samuelpabuena2008/capsense-lab/docs/arquitectura.md

# Arquitectura

El dashboard está separado en capas. Cada capa solo conoce a la de abajo, así la matemática se prueba sin hardware y la interfaz no sabe si los datos vienen del Arduino, del simulador o de un archivo.

```mermaid
flowchart LR
    subgraph Fuentes["io/ · fuentes de datos (un hilo cada una)"]
        A[serial_source<br/>Arduino por USB]
        B[simulator_source<br/>modo demo]
        C[replay_source<br/>log o CSV]
    end
    A & B & C -- "líneas de texto" --> P[io/protocol<br/>parser → eventos]
    P --> S[services/session<br/>estado + mediciones<br/>con lock]
    S --> L[services/storage<br/>logs/ por sesión]
    S -- "snapshot()" --> U[ui/<br/>Dash + Plotly]
    D[domain/<br/>physics · steps · models] --> U
    D --> S
    U -- "Medir → M" --> A
    U -- "Medir → M" --> B
```

## Capas

| Capa | Archivos | Qué hace | Depende de |
|---|---|---|---|
| Dominio | `domain/models.py`, `physics.py`, `steps.py` | Dataclasses, réplica de la matemática del firmware y los pasos con números sustituidos. Sin serial ni UI. | nada |
| Entrada | `io/base.py`, `protocol.py`, `*_source.py` | Las tres fuentes entregan **texto línea por línea**, como el puerto serie. El parser lo convierte en eventos. | dominio |
| Servicios | `services/session.py`, `storage.py` | Estado del equipo, ciclo de vida de cada medición, historial y logs. | dominio, entrada |
| Interfaz | `ui/app.py`, `layout.py`, `callbacks.py`, `figures.py`, `formulas.py` | Página Dash. Lee la sesión cada 400 ms y solo redibuja si cambió `version`. | todas |

## Hilos

- Cada fuente corre en su propio hilo `daemon` y llama a `Session.recibir_linea()`.
- `Session` protege todo con un único `RLock`. La interfaz pide `snapshot()`, que devuelve copias.
- Las `Run` no se modifican después de agregarse a una medición (los t1/t2 de la v2.1 se reconstruyen antes, dentro del lock).

## Estados del equipo

```mermaid
stateDiagram-v2
    [*] --> Desconectado
    Desconectado --> Conectado: se abre el puerto
    Conectado --> Listo: #VERSION / #LISTO
    Listo --> Descargando: #INICIO
    Descargando --> Midiendo: #PRUEBA_INI
    Midiendo --> Descargando: #PRUEBA
    Descargando --> Listo: #RESULTADO / #FIN
    Midiendo --> Error: #ERROR
    Error --> Descargando: #INICIO (nueva medición)
    Listo --> Desconectado: se suelta el cable
```

Con el firmware v2.1 no hay `#PRUEBA_INI`: el estado pasa a *Midiendo* con la cabecera de la tabla y a *Listo* con la línea CSV del resultado.

## Simulación del circuito

`domain/simulation.py` tiene la física pura (carga, descarga, fuga, ADC) y repite `medir()` del firmware. `ui/simulation/` arma la pestaña: `steps_data.py` (pasos como datos), `board_layout.py` (posiciones del montaje), `circuit_schematic.py` y `board_view.py` (los dos SVG) y `guion.py` (une todo para un caso). El navegador solo anima (`assets/simulation.js`, con `requestAnimationFrame`) los arreglos que manda Python en un `dcc.Store`.

## Ventana de escritorio

`desktop.py` levanta el servidor de Dash con `werkzeug.make_server` en un hilo, solo en `127.0.0.1` y en un puerto libre, y abre una ventana de pywebview (WebView2 en Windows). Al cerrar la ventana se apaga el servidor, se suelta el puerto serie y se cierran los logs. La página puede llamar a Python con `window.pywebview.api` (por ejemplo, pantalla completa). Con `--navegador` o `--servidor` se usa el servidor de Dash de siempre.

## Archivos que genera una sesión

En `logs/` (fuera de git):

- `sesion_AAAAMMDD_HHMMSS_serial.log`: todo lo recibido, con marca de tiempo. Se puede reproducir con `--replay`.
- `sesion_..._mediciones.csv`: una fila por medición (el historial).
- `sesion_..._pruebas.csv`: una fila por prueba, con t1 y t2. También se puede reproducir.
- `capsense.log`: log de la aplicación (rotativo, 1 MB × 3).
