samuelpabuena2008/capsense-lab/docs/img/sim-carga.jpg

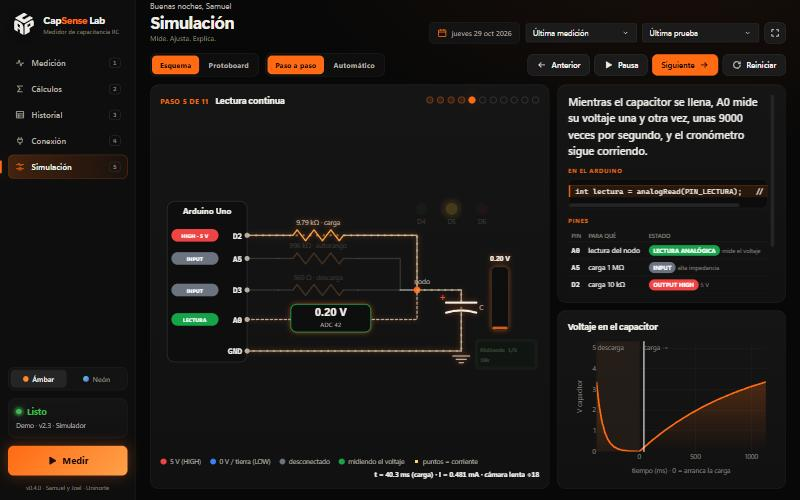
docs/img/sim-carga.jpg
