samuelpabuena2008/capsense-lab/docs/referencia/montaje.html

# Montaje CapSense Lab

Medidor de capacitancia RC con Arduino Uno, pantalla LCD 16×2, 3 botones y 3 LEDs. Los números 1 a 30 están como en tu placa (el 1 a la derecha). Las letras a–e y f–j son los hoyos de cada fila.

aro azul = hoyos de la etapa actual (+) y riel rojo (−) y riel azul cuadros numerados = pines de la LCD ↑ = cable largo al riel de arriba (cualquier hoyo)

Etapa anterior Etapa siguiente

## Hoyo por hoyo

## Materiales
