samuelpabuena2008/capsense-lab/(commit log)

2026-10-29 Agrega firmware v2.1 del medidor de capacitancia
    Arduino Uno con LCD 16x2, 3 botones, 3 LEDs y autorango 10k/1M.
    Mide t1 (ADC 250) y t2 (ADC 700) y ajusta la curva de carga.
2026-10-29 Agrega calc.py: réplica de la matemática del firmware
    Bisección de 30 iteraciones para la meseta P, tau, C, Q, E,
    incertidumbre por semi-rango y reconstrucción de t1/t2 desde (tau, P).
2026-10-29 Agrega parser.py para los protocolos serie v2.1 y v2.2
    Máquina de estados que emite eventos tipados; tolera basura y
    líneas partidas, y no duplica pruebas cuando la v2.2 manda ambos formatos.
2026-10-29 Reorganiza el proyecto en src layout
    Paquete capsense con pyproject.toml (dependencias, extras dev, entry
    point, ruff, pytest y mypy), configuración en config/capsense.toml
    validada con dataclasses, logging estándar y firmware en firmware/.
2026-10-29 Agrega el dominio: modelos, física y pasos de cálculo
    physics.py replica la matemática del firmware (bisección de 30
    iteraciones, tau, C, Q, E, incertidumbre por semi-rango) y steps.py
    arma las fórmulas con los números sustituidos y el chequeo contra lo
    que reportó el Arduino.
2026-10-29 Agrega las fuentes de datos: protocolo, demo, replay y serial
    - protocol.py entiende la salida legible v2.1 y la de prefijos # v2.2
    - simulator_source.py imita el firmware v2.2 con ruido, fuga, latencia
    de analogRead y resolución de micros()
    - replay_source.py reproduce logs seriales y CSV de pruebas
    - serial_source.py lee en un hilo, autodetecta el puerto y reconecta
2026-10-29 Agrega la sesión y el almacenamiento
    Estado del equipo y ciclo de vida de cada medición con un solo lock,
    log serial y CSV automáticos por sesión en logs/ y exportación.
2026-10-29 Agrega el dashboard Dash y la línea de comandos
    Resultado grande con unidad automática, curva de carga con muestras,
    ajuste, t1/t2, meseta, tau y guías, pasos con MathJax, C por prueba,
    tarjetas, historial con exportación y tema oscuro para proyector.
    python -m capsense --demo | --replay ARCHIVO | --port COM3
2026-10-29 Agrega tests unitarios, de integración y fixtures
    Cubren la física con los valores de referencia de 100 uF, el parser con
    transcripciones completas, cortadas y con basura, los pasos, el
    almacenamiento, la configuración y una sesión completa con el simulador,
    incluido un barrido de 1 a 1000 uF.
    [generar_fixtures.py, test_config.py, test_physics.py, test_protocol.py, test_simulator.py, test_steps.py, test_storage.py]
2026-10-29 Agrega el firmware v2.2
    Captura hasta 100 muestras de la curva (espaciado geométrico desde
    0,5 ms) sin imprimir nada mientras se mide t1 y t2, y las envía después
    de cada prueba. La última prueba sigue hasta la meseta. Protocolo con
    prefijo #, 115200 baud y comandos M (medir) y V (versión). La medición,
    el LCD, los LEDs, los botones y el autorango quedan como en la v2.1.
    Compila para arduino:avr:uno: 15 482 bytes de flash (47 %) y 1204
    bytes de RAM global (58 %).
    El simulador guarda el próximo instante de muestreo como entero, igual
    que el firmware.
2026-10-29 Agrega la documentación y el script para grabar logs
    README con capturas, instalación, uso y solución de problemas;
    arquitectura, protocolo serie y cálculos (con los límites de exactitud
    del firmware medidos con el simulador); CHANGELOG; y
    scripts/grabar_log.py para guardar una medición real como fixture.
    [grabar_log.py]
2026-10-29 Agrega el firmware v2.3 con cruces interpolados
    t1 y t2 se detectan sobre la media móvil de las últimas 8 lecturas (con
    su tiempo medio) y se interpolan entre la vuelta anterior y la actual,
    corrigiendo el retardo de muestreo del ADC. Por vuelta solo se agregan
    sumas de enteros; la cuenta en float se hace una vez por cruce.
    En el simulador el peor error pasa de +5.0 % (1.5 uF con fuga) y
    -1.6 % (1000 uF con ruido) a menos de 1 % en todo el rango.
    Compila para el Uno: 16 528 bytes de flash (51 %), 1252 de RAM (61 %).
    [capsense_lab_v2_3.ino]
2026-10-29 Simula el firmware v2.3 y permite elegirlo en la demo
    El simulador reproduce la detección de la v2.3 con los mismos enteros
    que el Arduino y un bucle ~5 us más lento. El panel demo y [demo]
    firmware en el TOML eligen entre v2.3 y v2.2. Tests nuevos comparan
    las dos versiones y el barrido de 1 a 1000 uF corre con ambas.
2026-10-29 Documenta la v2.3 y publica la versión 0.2.0
    Tabla de exactitud v2.2 contra v2.3, explicación de por qué fallaba la
    v2.2 y qué cambia, protocolo con t1/t2 decimales, README y CHANGELOG.
2026-10-29 Abre CapSense Lab como aplicación de escritorio
    La app corre en su propia ventana con pywebview (WebView2 en Windows):
    el servidor de Dash queda en un hilo, solo en 127.0.0.1 y en un puerto
    libre, y se apaga al cerrar la ventana. CapSense Lab.pyw y el comando
    capsense-app la abren sin consola. --navegador y --servidor mantienen
    los modos anteriores; si no hay WebView2, cae al navegador.
2026-10-29 Rediseña la interfaz como app con la skill ui-ux-pro-max
    Estilo Dark Mode (OLED) + Data-Dense Dashboard + Real-Time Monitoring:
    barra lateral con vistas Medición, Cálculos, Historial y Conexión,
    estado del equipo y botón Medir siempre visibles, vista de medición sin
    scroll, Segoe UI Variable + Cascadia Code, íconos SVG propios, barra de
    progreso, avisos como toasts, foco visible, movimiento reducido y
    atajos (M, 1-4, F11).
2026-10-29 Documenta la aplicación de escritorio y publica la versión 0.3.0
2026-10-29 Arregla el cuelgue de la ventana de escritorio
    pywebview recorría el objeto ventana guardado en la API expuesta a la
    página y se quedaba en un bucle por los objetos nativos de Windows: el
    atributo pasa a ser privado. Además la ventana usa un perfil temporal
    de WebView2 y un puerto aleatorio, para que una sesión anterior o una
    pestaña vieja del navegador no interfieran.
2026-10-30 Agrega el logo: cubo isométrico con las letras CAP
    Cada letra se dibuja en un cuadrado con recortes (máscaras) y se
    proyecta sobre su cara del cubo con una transformación isométrica.
    Versión transparente para la app y otra con fondo para el README.
2026-10-30 Rediseña la app con temas Ámbar y Neón
    Inspirado en tableros con más personalidad: saludo y fecha en la
    cabecera, tarjetas KPI con mini-gráficas y variación contra la medición
    anterior, curva de carga con área y brillo, panel de calidad por
    factores, desviación de cada prueba, mediciones recientes y mapa de
    calor de repetibilidad en el historial. El tema se elige en la barra
    lateral y se recuerda; las gráficas usan la paleta del tema.
2026-10-30 Documenta el nuevo diseño y publica la versión 0.4.0
2026-10-30 Agrega la física de la simulación del circuito y los pines en config
    domain/simulation.py calcula carga, descarga y fuga del montaje real y
    repite medir() del firmware v2.1 (autorango, repeticiones, errores).
    Los pines del Arduino y la resistencia de descarga pasan a
    config/capsense.toml. Se copia el montaje de referencia a
    docs/referencia/montaje.html.
    [test_simulation.py]
2026-10-30 Agrega la vista Simulación: animación del circuito paso a paso
    Explica al público cómo mide el circuito: esquema y protoboard del
    montaje real, corriente animada, capacitor que se llena, estado de los
    pines, LEDs, LCD y curva V(t), siguiendo lo que hace el firmware v2.1.
    Pasos como datos (steps_data.py) y posiciones en board_layout.py.
2026-10-30 Documenta la simulación y publica la versión 0.5.0
    Incluye el hallazgo del voltaje residual al empezar a cargar, que hace
    que el firmware mida bajo los capacitores grandes.
2026-10-30 Agrega la gráfica de carga Q(t) con botón para cambiar desde V(t)
    En la vista Medición y en la Simulación, un botón V(t) / Q(t) cambia la
    curva entre voltaje y carga almacenada. Q(t) = C·V(t) con la C de cada
    prueba, en µC o mC, con Q máx en la meseta y el voltaje equivalente en
    el eje derecho. Versión 0.6.0.
2026-10-30 Arregla el botón V(t)/Q(t) que quedaba encendido y cambia el título
    La opción activa de los controles segmentados se marcaba con
    :has(input:checked), que el navegador no siempre repintaba, y el fondo
    tenía una transición que podía quedarse a mitad: la opción anterior
    seguía naranja. Ahora usa la clase .selected que Dash actualiza, sin
    transición. El título de la curva cambia entre 'Voltaje del capacitor ·
    V(t)' y 'Carga del capacitor · Q(t)'.
    [callbacks.py, layout.py]
